waltermin/recurse-charm-hardware/rc_keychain.kicad_pcb

## KiCad design rc_keychain.kicad_pcb (2026-04-25)

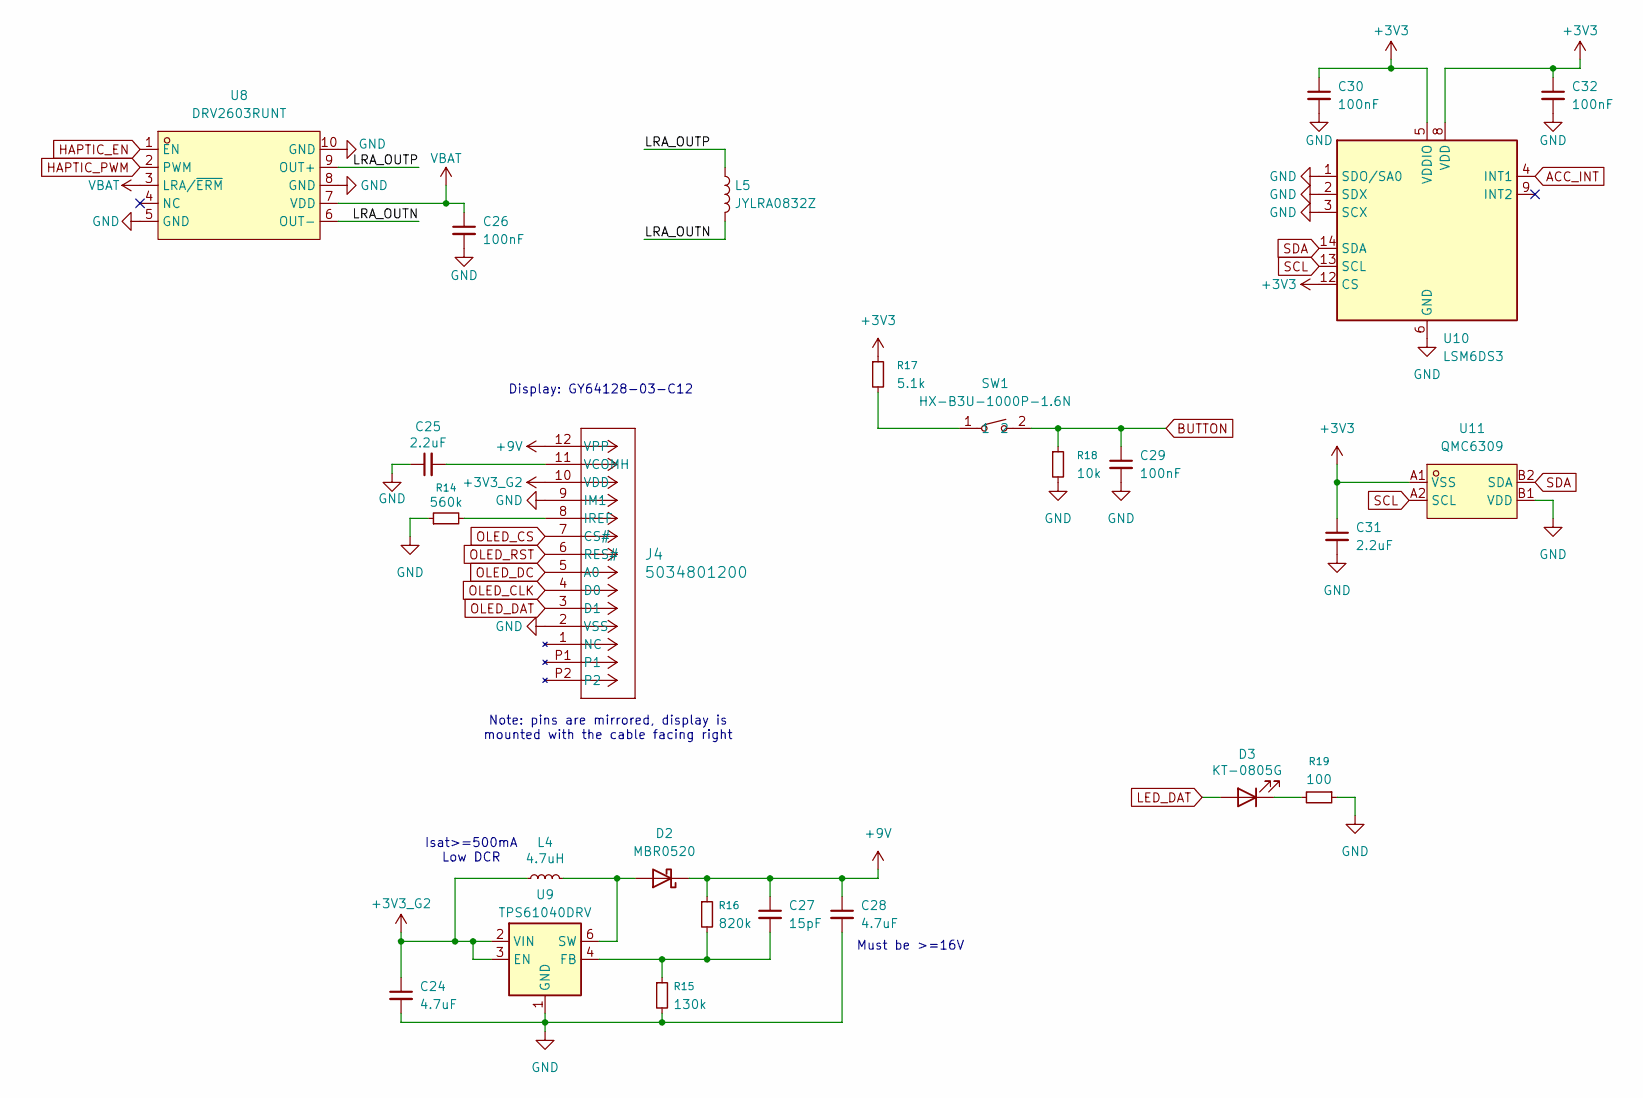
[picture p1: schematic interface.kicad_sch]

Parts:
C24: 4.7uF; C_0402_1005Metric; LCSC Part C23733
C25, C31: 2.2uF; C_0402_1005Metric; LCSC Part C12530
C26, C29, C30, C32: 100nF; C_0402_1005Metric; LCSC Part C1525
C27: 15pF; C_0402_1005Metric; LCSC Part C1548
C28: 4.7uF; C_0603_1608Metric; LCSC Part C19666
D2: MBR0520; D_SOD-323; LCSC Part C49238168
D3: KT-0805G; D_0805_2012Metric; LCSC Part C2297
J4: 5034801200; CON_5034801200_MOL; LCSC Part C587969
L4: 4.7uH; IND-SMD_L2.0-W1.6-B; LCSC Part C5832346
L5: JYLRA0832Z; Generic_Solder_Pads_2P
R14: 560k; R_0402_1005Metric; LCSC Part C132339
R15: 130k; R_0402_1005Metric; LCSC Part C93946
R16: 820k; R_0402_1005Metric; LCSC Part C67558
R17: 5.1k; R_0402_1005Metric; LCSC Part C25905
R18: 10k; R_0402_1005Metric; LCSC Part C25744
R19: 100; R_0402_1005Metric; LCSC Part C25076
SW1: HX-B3U-1000P-1.6N; SW-SMD_2P-L3.0-W2.5-LS4.0; MPN HX-B3U-1000P-1.6N; LCSC Part C49234121
U8: DRV2603RUNT; QFN-10_L2.0-W2.0-P0.50-TL; LCSC Part C2150691
U9: TPS61040DRV; WSON-6-1EP_2x2mm_P0.65mm_EP1x1.6mm; LCSC Part C2678534
U10: LSM6DS3; LGA-14_3x2.5mm_P0.5mm_LayoutBorder3x4y; LCSC Part C967633
U11: QMC6309; X1-WLB0808-4_L0.8-W0.8-P0.40-TL; MPN QMC6309; LCSC Part C5439871

Connections:
+3V3: C30.1, C31.1, C32.1, R17.1, U10.5 (VDDIO), U10.8 (VDD), U10.12 (CS), U11.A1 (VSS); also elsewhere on the board
+3V3_G2: C24.1, J4.10 (VDD), L4.1, U9.2 (VIN), U9.3 (EN); also elsewhere on the board
+9V: C27.1, C28.1, D2.1 (K), J4.12 (VPP), R16.1
/interface/LRA_OUTN: L5.2, U8.6 (OUT-)
/interface/LRA_OUTP: L5.1, U8.9 (OUT+)
ACC_INT: U10.4 (INT1); also elsewhere on the board
BUTTON: C29.1, R18.1, SW1.2; also elsewhere on the board
GND: C24.2, C25.1, C26.2, C28.2, C29.2, C30.2, C31.2, C32.2, J4.2 (VSS), J4.9 (IM1), R14.1, R15.2, R18.2, R19.1, U8.5 (GND), U8.8 (GND), U8.10 (GND), U9.1 (GND), U10.1 (SDO/SA0), U10.2 (SDX), U10.3 (SCX), U10.6 (GND), U10.7 (GND), U11.B1 (VDD); also elsewhere on the board
HAPTIC_EN: U8.1 (EN); also elsewhere on the board
HAPTIC_PWM: U8.2 (PWM); also elsewhere on the board
LED_DAT: D3.2 (A); also elsewhere on the board
unnamed: D2.2 (A), L4.2, U9.6 (SW)
unnamed: D3.1 (K), R19.2
unnamed: J4.8 (IREF), R14.2
unnamed: C25.2, J4.11 (VCOMH)
unnamed: R17.2, SW1.1
unnamed: C27.2, R15.1, R16.2, U9.4 (FB)
OLED_CLK: J4.4 (D0); also elsewhere on the board
OLED_CS: J4.7 (CS#); also elsewhere on the board
OLED_DAT: J4.3 (D1); also elsewhere on the board
OLED_DC: J4.5 (A0); also elsewhere on the board
OLED_RST: J4.6 (RES#); also elsewhere on the board
SCL: U10.13 (SCL), U11.A2 (SCL); also elsewhere on the board
SDA: U10.14 (SDA), U11.B2 (SDA); also elsewhere on the board
VBAT: C26.1, U8.3 (LRA/~ERM), U8.7 (VDD); also elsewhere on the board

Notes on the sheet:
Display: GY64128-03-C12
Isat>=500mA Low DCR
Note: pins are mirrored, display is mounted with the cable facing right
Must be >=16V

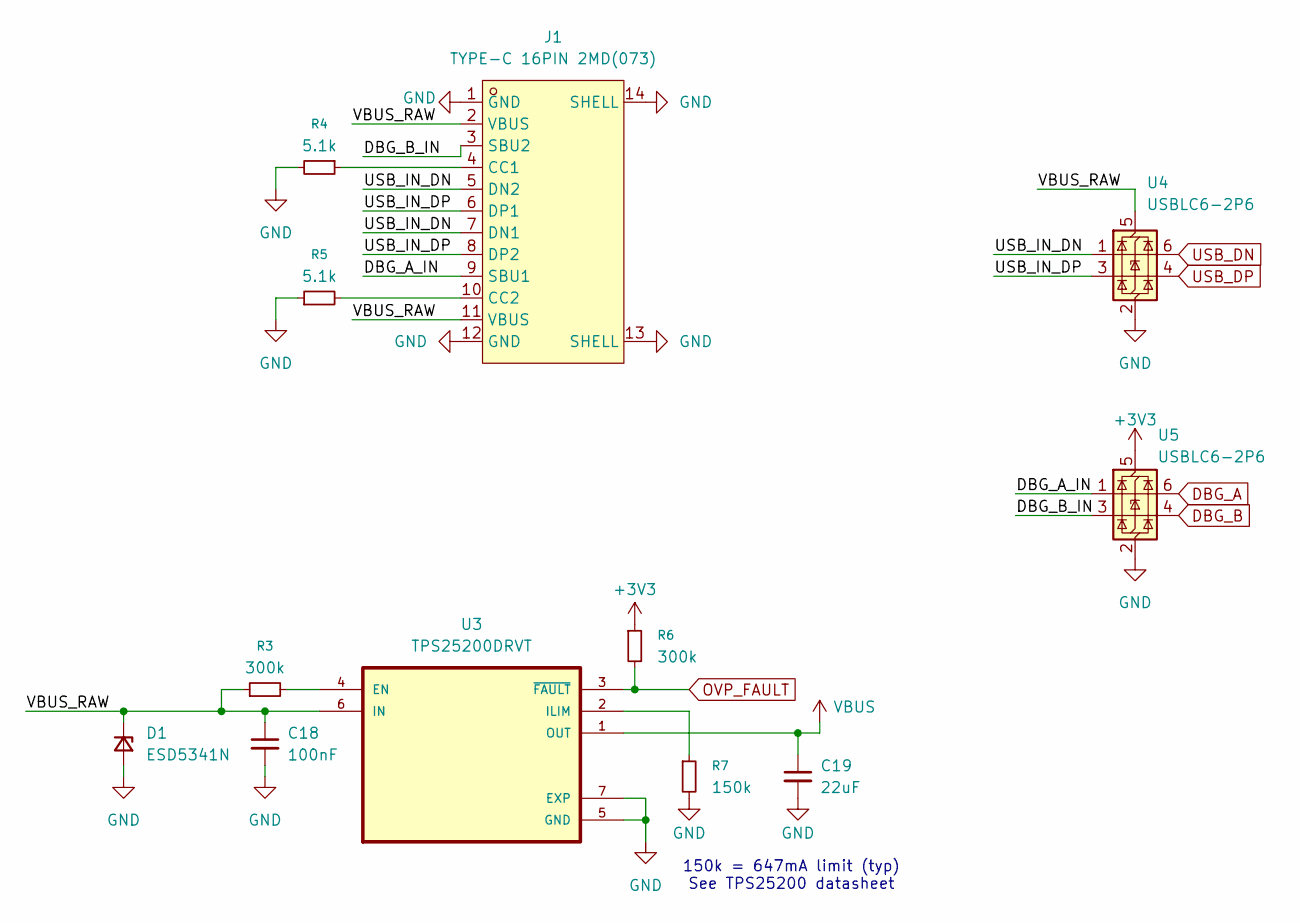
[picture p2: schematic usb.kicad_sch]

Parts:
C18: 100nF; C_0402_1005Metric; LCSC Part C1525
C19: 22uF; C_0402_1005Metric; LCSC Part C47339
D1: ESD5341N; D_SOD-882; LCSC Part C3021106
J1: TYPE-C 16PIN 2MD(073); USB-C-SMD_TYPE-C-6PIN-2MD-073; LCSC Part C2765186
R3, R6: 300k; R_0402_1005Metric; LCSC Part C25774
R4, R5: 5.1k; R_0402_1005Metric; LCSC Part C25905
R7: 150k; R_0402_1005Metric; LCSC Part C2909320
U3: TPS25200DRVT; SON65P200X200X80-7N; DigiKey_Part_Number 296-37760-1-ND
U4, U5: USBLC6-2P6; SOT-666; LCSC Part C2827693

Connections:
+3V3: R6.1, U5.5 (VBUS); also elsewhere on the board
/usb/DBG_A_IN: J1.9 (SBU1), U5.1 (I/O1)
/usb/DBG_B_IN: J1.3 (SBU2), U5.3 (I/O2)
/usb/USB_IN_DN: J1.5 (DN2), J1.7 (DN1), U4.1 (I/O1)
/usb/USB_IN_DP: J1.6 (DP1), J1.8 (DP2), U4.3 (I/O2)
/usb/VBUS_RAW: C18.1, D1.1 (K), J1.2 (VBUS), J1.11 (VBUS), R3.1, U3.6 (IN), U4.5 (VBUS)
DBG_A: U5.6 (I/O1); also elsewhere on the board
DBG_B: U5.4 (I/O2); also elsewhere on the board
GND: C18.2, C19.2, D1.2 (A), J1.1 (GND), J1.12 (GND), J1.13 (SHELL), J1.14 (SHELL), R4.2, R5.1, R7.2, U3.5 (GND), U3.7 (EXP), U4.2 (GND), U5.2 (GND); also elsewhere on the board
unnamed: J1.4 (CC1), R4.1
unnamed: J1.10 (CC2), R5.2
unnamed: R3.2, U3.4 (EN)
unnamed: R7.1, U3.2 (ILIM)
OVP_FAULT: R6.2, U3.3 (~FAULT)
USB_DN: U4.6 (I/O1); also elsewhere on the board
USB_DP: U4.4 (I/O2); also elsewhere on the board
VBUS: C19.1, U3.1 (OUT); also elsewhere on the board

Notes on the sheet:
150k = 647mA limit (typ) See TPS25200 datasheet

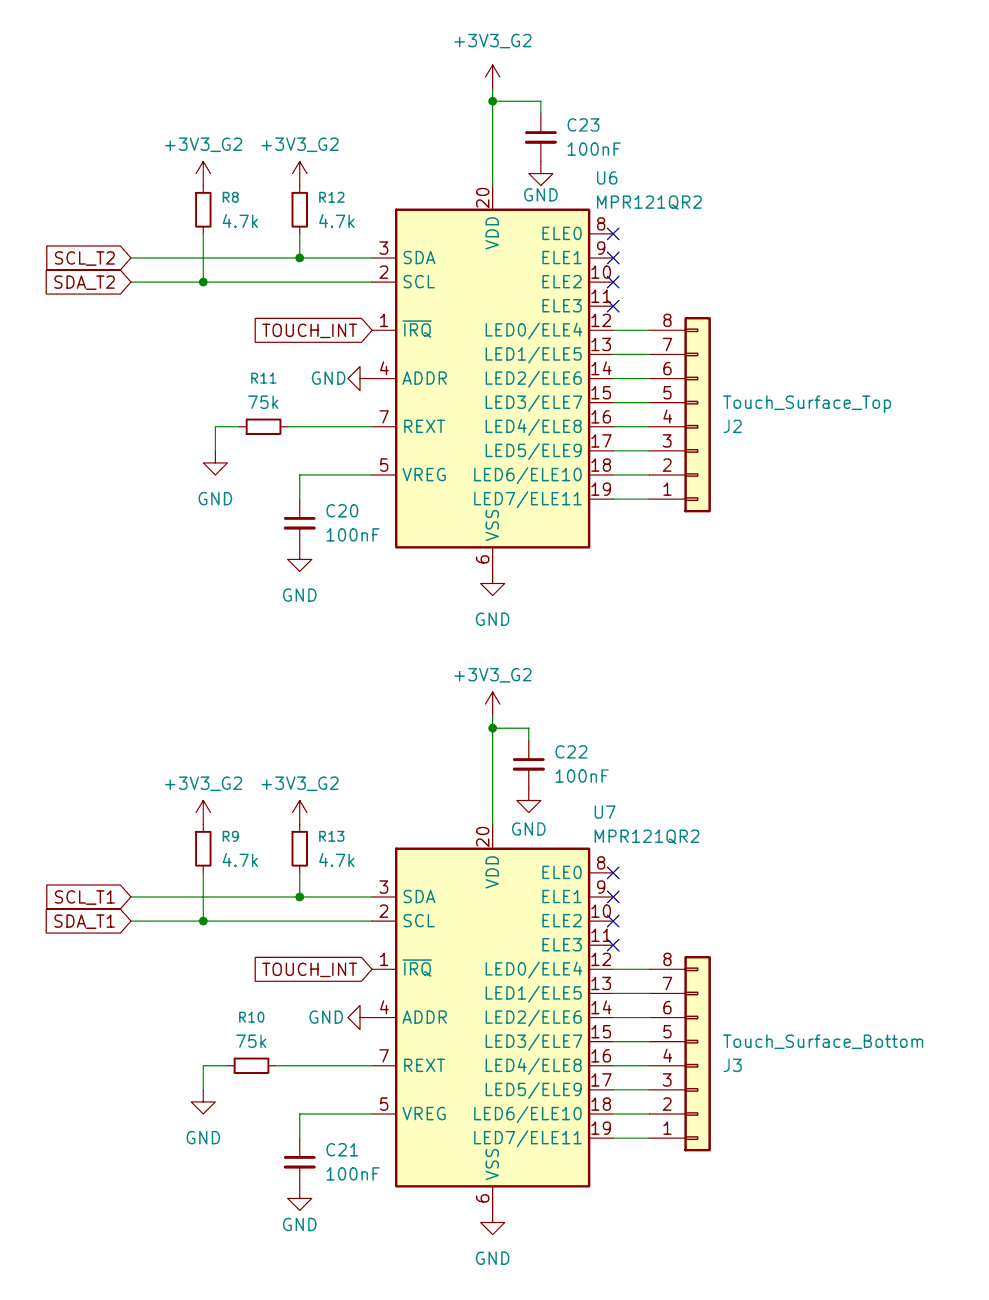
[picture p3: schematic touch.kicad_sch]

Parts:
C20, C21, C22, C23: 100nF; C_0402_1005Metric; LCSC Part C1525
J2: Touch_Surface_Top; Touch_Surface_8_Pad_Slim
J3: Touch_Surface_Bottom; Touch_Surface_8_Pad_Slim
R8, R9, R12, R13: 4.7k; R_0402_1005Metric; LCSC Part C25900
R10, R11: 75k; R_0402_1005Metric; LCSC Part C25798
U6, U7: MPR121QR2; UQFN-20_3x3mm_P0.4mm; LCSC Part C91322

Connections:
+3V3_G2: C22.1, C23.1, R8.1, R9.1, R12.1, R13.1, U6.20 (VDD), U7.20 (VDD); also elsewhere on the board
GND: C20.2, C21.2, C22.2, C23.2, R10.1, R11.1, U6.4 (ADDR), U6.6 (VSS), U7.4 (ADDR), U7.6 (VSS); also elsewhere on the board
unnamed: J2.1, U6.19 (LED7/ELE11)
unnamed: J2.2, U6.18 (LED6/ELE10)
unnamed: J2.3, U6.17 (LED5/ELE9)
unnamed: J2.4, U6.16 (LED4/ELE8)
unnamed: J2.5, U6.15 (LED3/ELE7)
unnamed: J2.6, U6.14 (LED2/ELE6)
unnamed: J2.7, U6.13 (LED1/ELE5)
unnamed: J2.8, U6.12 (LED0/ELE4)
unnamed: J3.1, U7.19 (LED7/ELE11)
unnamed: J3.2, U7.18 (LED6/ELE10)
unnamed: J3.3, U7.17 (LED5/ELE9)
unnamed: J3.4, U7.16 (LED4/ELE8)
unnamed: J3.5, U7.15 (LED3/ELE7)
unnamed: J3.6, U7.14 (LED2/ELE6)
unnamed: J3.7, U7.13 (LED1/ELE5)
unnamed: J3.8, U7.12 (LED0/ELE4)
unnamed: R11.2, U6.7 (REXT)
unnamed: C20.1, U6.5 (VREG)
unnamed: R10.2, U7.7 (REXT)
unnamed: C21.1, U7.5 (VREG)
SCL_T1: R13.2, U7.3 (SDA); also elsewhere on the board
SCL_T2: R12.2, U6.3 (SDA); also elsewhere on the board
SDA_T1: R9.2, U7.2 (SCL); also elsewhere on the board
SDA_T2: R8.2, U6.2 (SCL); also elsewhere on the board
TOUCH_INT: U6.1 (~IRQ), U7.1 (~IRQ); also elsewhere on the board

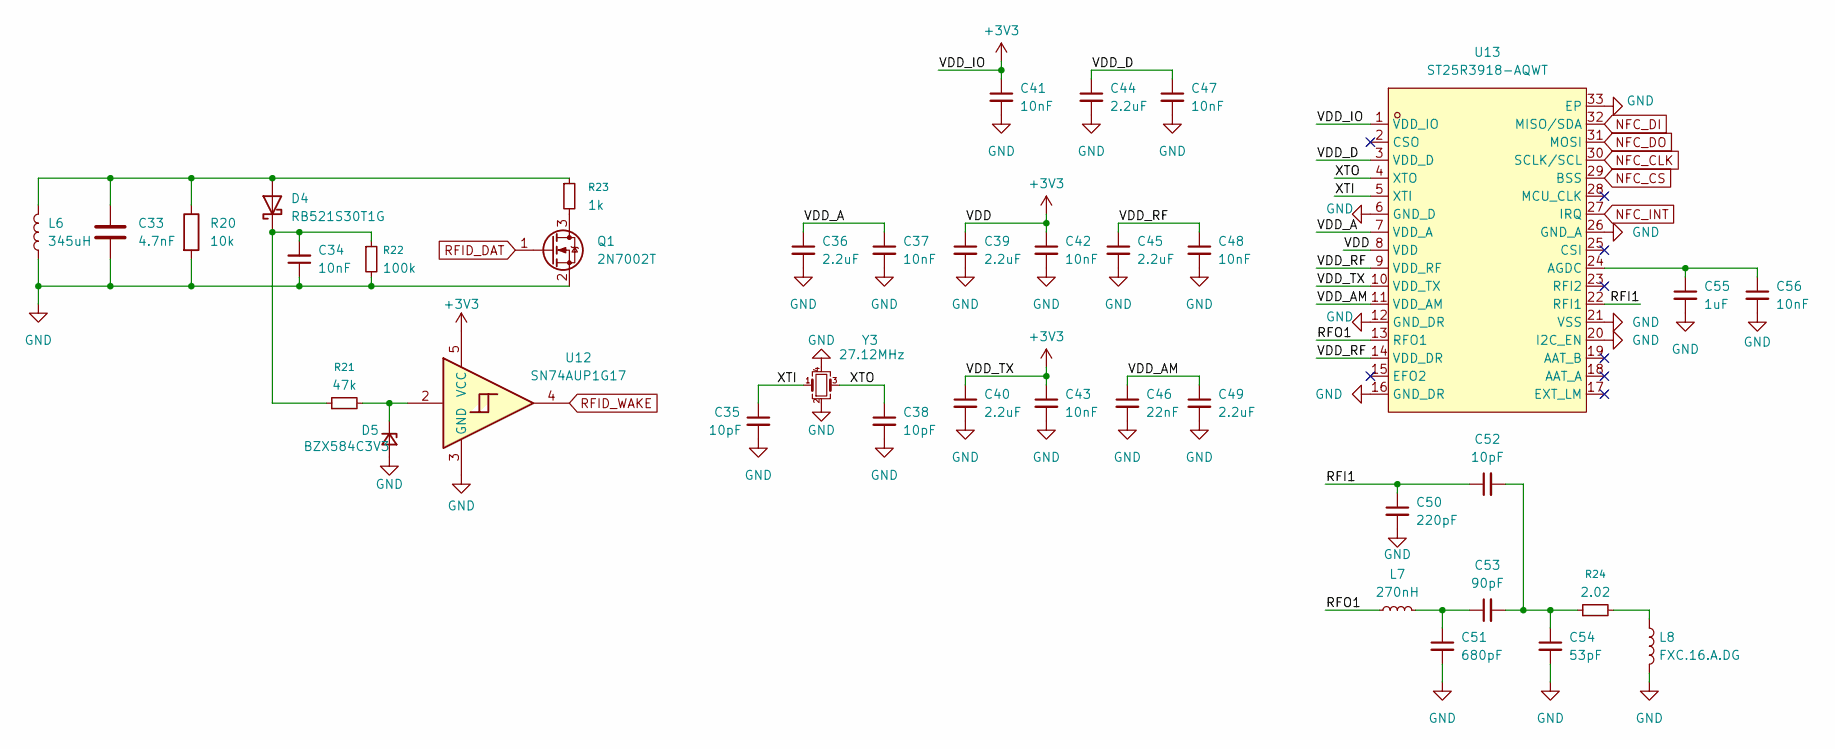
[picture p4: schematic rf.kicad_sch]

Parts:
C33: 4.7nF; C_0402_1005Metric; LCSC Part C1538
C34: 10nF; C_0402_1005Metric; LCSC Part C15195
C35, C38, C52: 10pF; C_0402_1005Metric; LCSC Part C32949
C36, C39, C40, C44, C45, C49: 2.2uF; C_0201_0603Metric; LCSC Part C335106
C37, C41, C42, C43, C47, C48, C56: 10nF; C_0201_0603Metric; LCSC Part C272853
C46: 22nF; C_0201_0603Metric; LCSC Part C668343
C50: 220pF; C_0402_1005Metric; LCSC Part C71693
C51: 680pF; C_0402_1005Metric; LCSC Part C307451
C53: 90pF; C_0402_1005Metric; LCSC Part C1864488
C54: 53pF; C_0402_1005Metric; LCSC Part C541437
C55: 1uF; C_0201_0603Metric; LCSC Part C53067
D4: RB521S30T1G; D_SOD-523; LCSC Part C145179
D5: BZX584C3V3; D_SOD-523; LCSC Part C19077462
L6: 345uH; Generic_Solder_Pads_2P
L7: 270nH; L_0603_1608Metric; LCSC Part C2041707
L8: FXC.16.A.DG; Generic_Solder_Pads_2P
Q1: 2N7002T; SOT-523; LCSC Part C2844731
R20: 10k; R_0402_1005Metric; LCSC Part C25744
R21: 47k; R_0402_1005Metric; LCSC Part C25792
R22: 100k; R_0402_1005Metric; LCSC Part C25741
R23: 1k; R_0402_1005Metric; LCSC Part C11702
R24: 2.02; R_0402_1005Metric; LCSC Part C2998051
U12: SN74AUP1G17; Diodes_SOT-553; LCSC Part C49374609
U13: ST25R3918-AQWT; QFN-32_L5.0-W5.0-P0.50-TL-EP3.5; LCSC Part C3304617
Y3: 27.12MHz; Crystal_SMD_2016-4Pin_2.0x1.6mm; LCSC Part C7301953

Connections:
+3V3: C39.1, C40.1, C41.1, C42.1, C43.1, U12.5 (VCC), U13.1 (VDD_IO), U13.8 (VDD), U13.10 (VDD_TX); also elsewhere on the board
/rf/RFI1: C50.1, C52.1, U13.22 (RFI1)
/rf/RFO1: L7.1, U13.13 (RFO1)
/rf/VDD_A: C36.1, C37.1, U13.7 (VDD_A)
/rf/VDD_AM: C46.1, C49.1, U13.11 (VDD_AM)
/rf/VDD_D: C44.1, C47.1, U13.3 (VDD_D)
/rf/VDD_RF: C45.1, C48.1, U13.9 (VDD_RF), U13.14 (VDD_DR)
/rf/XTI: C35.1, U13.5 (XTI), Y3.1
/rf/XTO: C38.1, U13.4 (XTO), Y3.3
GND: C33.2, C34.1, C35.2, C36.2, C37.2, C38.2, C39.2, C40.2, C41.2, C42.2, C43.2, C44.2, C45.2, C46.2, C47.2, C48.2, C49.2, C50.2, C51.2, C54.2, C55.2, C56.2, D5.2 (A), L6.1, L8.2, Q1.2 (S), R20.2, R22.2, U12.3 (GND), U13.6 (GND_D), U13.12 (GND_DR), U13.16 (GND_DR), U13.20 (I2C_EN), U13.21 (VSS), U13.26 (GND_A), U13.33 (EP), Y3.2, Y3.4; also elsewhere on the board
NFC_CLK: U13.30 (SCLK/SCL); also elsewhere on the board
NFC_CS: U13.29 (BSS); also elsewhere on the board
NFC_DI: U13.32 (MISO/SDA); also elsewhere on the board
NFC_DO: U13.31 (MOSI); also elsewhere on the board
NFC_INT: U13.27 (IRQ); also elsewhere on the board
unnamed: C51.1, C53.1, L7.2
unnamed: C52.2, C53.2, C54.1, R24.1
unnamed: C33.1, D4.2 (A), L6.2, R20.1, R23.1
unnamed: C34.2, D4.1 (K), R21.1, R22.1
unnamed: D5.1 (K), R21.2, U12.2
unnamed: L8.1, R24.2
unnamed: Q1.3 (D), R23.2
unnamed: C55.1, C56.1, U13.24 (AGDC)
RFID_DAT: Q1.1 (G); also elsewhere on the board
RFID_WAKE: U12.4; also elsewhere on the board

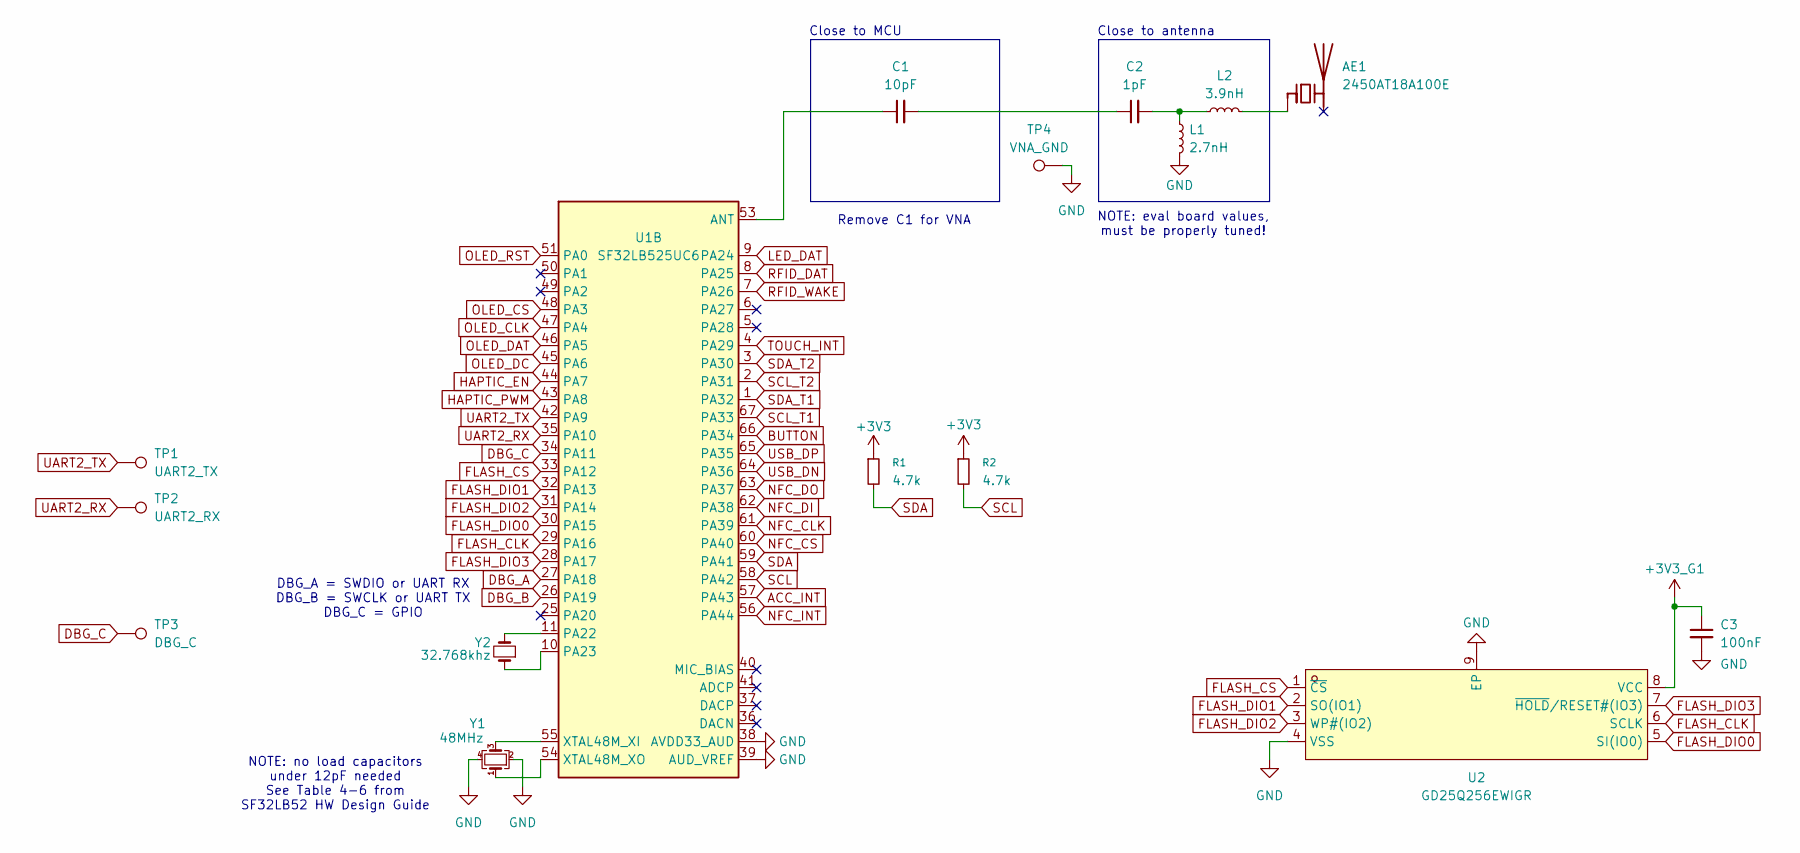
[picture p5: schematic mcu.kicad_sch]

Parts:
AE1: 2450AT18A100E; R_1206_3216Metric; LCSC Part C89334
C1: 10pF; C_0402_1005Metric; LCSC Part C32949
C2: 1pF; C_0603_1608Metric; LCSC Part C307493
C3: 100nF; C_0402_1005Metric; LCSC Part C1525
L1: 2.7nH; L_0603_1608Metric; LCSC Part C412027
L2: 3.9nH; L_0603_1608Metric; LCSC Part C13818
R1, R2: 4.7k; R_0402_1005Metric; LCSC Part C25900
TP1: UART2_TX; TestPoint_Pad_D1.0mm
TP2: UART2_RX; TestPoint_Pad_D1.0mm
TP3: DBG_C; TestPoint_Pad_D1.0mm
TP4: VNA_GND; TestPoint_Pad_D1.0mm
U1: SF32LB525UC6; ArtInChip_QFN-68-1EP_7x7mm_P0.35mm_EP5.49x5.49mm; LCSC Part C47355842
U2: GD25Q256EWIGR; WSON-8_L6.0-W5.0-P1.27-TL-EP; LCSC Part C6564321
Y1: 48MHz; Crystal_SMD_2016-4Pin_2.0x1.6mm; LCSC Part C49363531
Y2: 32.768khz; Crystal_SMD_2012-2Pin_2.0x1.2mm; LCSC Part C99009

Connections:
+3V3: R1.1, R2.1; also elsewhere on the board
+3V3_G1: C3.1, U2.8 (VCC); also elsewhere on the board
ACC_INT: U1.57 (PA43); also elsewhere on the board
BUTTON: U1.66 (PA34); also elsewhere on the board
DBG_A: U1.27 (PA18); also elsewhere on the board
DBG_B: U1.26 (PA19); also elsewhere on the board
DBG_C: TP3.1, U1.34 (PA11)
FLASH_CLK: U1.29 (PA16), U2.6 (SCLK)
FLASH_CS: U1.33 (PA12), U2.1 (~CS)
FLASH_DIO0: U1.30 (PA15), U2.5 (SI(IO0))
FLASH_DIO1: U1.32 (PA13), U2.2 (SO(IO1))
FLASH_DIO2: U1.31 (PA14), U2.3 (WP#(IO2))
FLASH_DIO3: U1.28 (PA17), U2.7 (~HOLD/RESET#(IO3))
GND: C3.2, L1.2, TP4.1, U1.38 (AVDD33_AUD), U1.39 (AUD_VREF), U2.4 (VSS), U2.9 (EP), Y1.2, Y1.4; also elsewhere on the board
HAPTIC_EN: U1.44 (PA7); also elsewhere on the board
HAPTIC_PWM: U1.43 (PA8); also elsewhere on the board
LED_DAT: U1.9 (PA24); also elsewhere on the board
NFC_CLK: U1.61 (PA39); also elsewhere on the board
NFC_CS: U1.60 (PA40); also elsewhere on the board
NFC_DI: U1.62 (PA38); also elsewhere on the board
NFC_DO: U1.63 (PA37); also elsewhere on the board
NFC_INT: U1.56 (PA44); also elsewhere on the board
unnamed: AE1.1 (FEED), L2.2
unnamed: C1.2, C2.1
unnamed: C2.2, L1.1, L2.1
unnamed: C1.1, U1.53 (ANT)
unnamed: U1.11 (PA22), Y2.2
unnamed: U1.10 (PA23), Y2.1
unnamed: U1.55 (XTAL48M_XI), Y1.3
unnamed: U1.54 (XTAL48M_XO), Y1.1
OLED_CLK: U1.47 (PA4); also elsewhere on the board
OLED_CS: U1.48 (PA3); also elsewhere on the board
OLED_DAT: U1.46 (PA5); also elsewhere on the board
OLED_DC: U1.45 (PA6); also elsewhere on the board
OLED_RST: U1.51 (PA0); also elsewhere on the board
RFID_DAT: U1.8 (PA25); also elsewhere on the board
RFID_WAKE: U1.7 (PA26); also elsewhere on the board
SCL: R2.2, U1.58 (PA42); also elsewhere on the board
SCL_T1: U1.67 (PA33); also elsewhere on the board
SCL_T2: U1.2 (PA31); also elsewhere on the board
SDA: R1.2, U1.59 (PA41); also elsewhere on the board
SDA_T1: U1.1 (PA32); also elsewhere on the board
SDA_T2: U1.3 (PA30); also elsewhere on the board
TOUCH_INT: U1.4 (PA29); also elsewhere on the board
UART2_RX: TP2.1, U1.35 (PA10)
UART2_TX: TP1.1, U1.42 (PA9)
USB_DN: U1.64 (PA36); also elsewhere on the board
USB_DP: U1.65 (PA35); also elsewhere on the board

Notes on the sheet:
NOTE: eval board values, must be properly tuned!
Remove C1 for VNA
Close to MCU
DBG_A = SWDIO or UART RX DBG_B = SWCLK or UART TX DBG_C = GPIO
NOTE: no load capacitors under 12pF needed See Table 4-6 from SF32LB52 HW Design Guide
Close to antenna

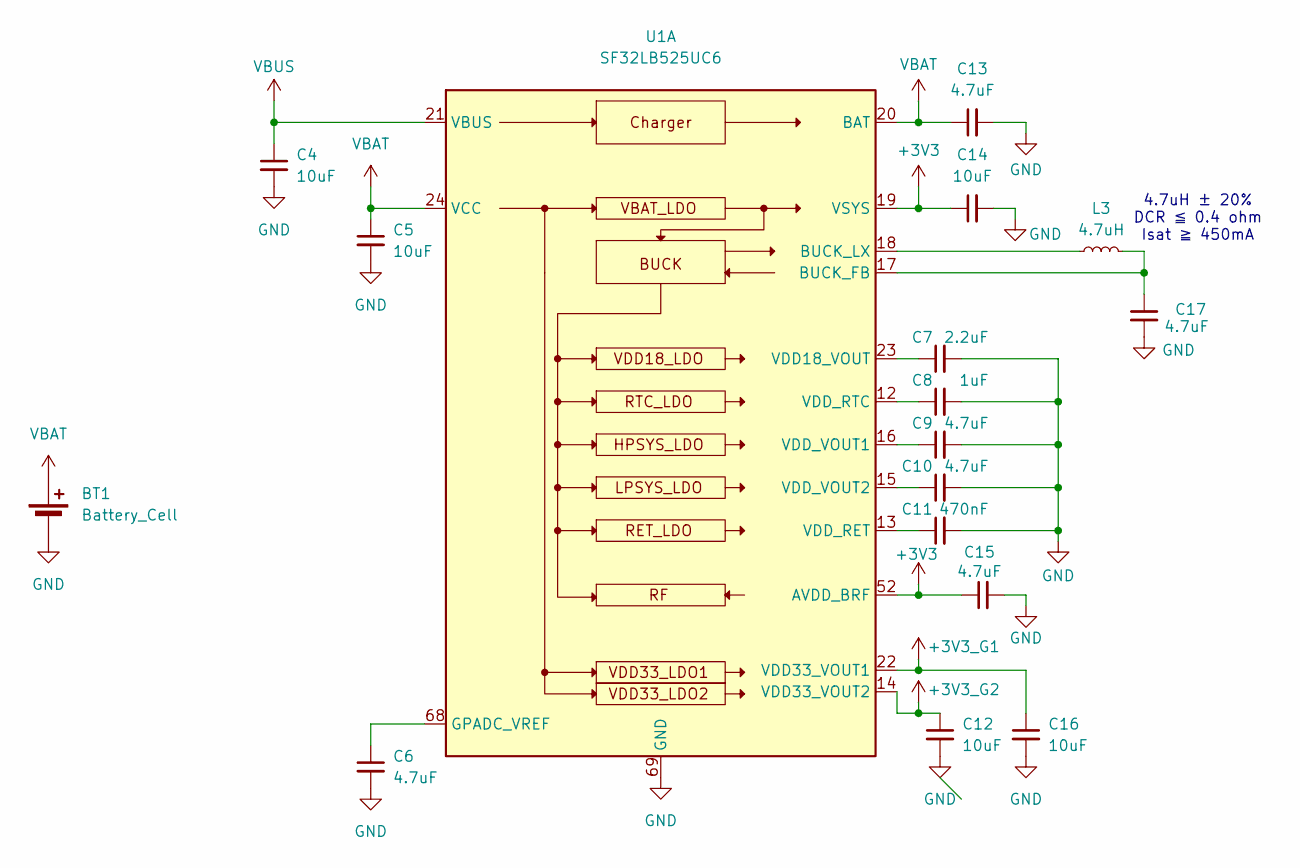
[picture p6: schematic power.kicad_sch]

Parts:
BT1: Battery_Cell; Generic_Solder_Pads_2P
C4, C5, C12, C14, C16: 10uF; C_0402_1005Metric; LCSC Part C15525
C6, C9, C10, C15: 4.7uF; C_0201_0603Metric; LCSC Part C335103
C7: 2.2uF; C_0201_0603Metric; LCSC Part C335106
C8: 1uF; C_0201_0603Metric; LCSC Part C53067
C11: 470nF; C_0201_0603Metric; LCSC Part C85926
C13, C17: 4.7uF; C_0402_1005Metric; LCSC Part C23733
L3: 4.7uH; L_0402_1005Metric; LCSC Part C86065
U1: SF32LB525UC6; ArtInChip_QFN-68-1EP_7x7mm_P0.35mm_EP5.49x5.49mm; LCSC Part C47355842

Connections:
+3V3: C14.1, C15.1, U1.19 (VSYS), U1.52 (AVDD_BRF); also elsewhere on the board
+3V3_G1: C16.1, U1.22 (VDD33_VOUT1); also elsewhere on the board
+3V3_G2: C12.1, U1.14 (VDD33_VOUT2); also elsewhere on the board
GND: BT1.2 (-), C4.2, C5.2, C6.2, C7.2, C8.2, C9.2, C10.2, C11.2, C12.2, C13.2, C14.2, C15.2, C16.2, C17.2, U1.69 (GND); also elsewhere on the board
unnamed: C17.1, L3.2, U1.17 (BUCK_FB)
unnamed: L3.1, U1.18 (BUCK_LX)
unnamed: C6.1, U1.68 (GPADC_VREF)
unnamed: C7.1, U1.23 (VDD18_VOUT)
unnamed: C11.1, U1.13 (VDD_RET)
unnamed: C8.1, U1.12 (VDD_RTC)
unnamed: C9.1, U1.16 (VDD_VOUT1)
unnamed: C10.1, U1.15 (VDD_VOUT2)
VBAT: BT1.1 (+), C5.1, C13.1, U1.20 (BAT), U1.24 (VCC); also elsewhere on the board
VBUS: C4.1, U1.21 (VBUS); also elsewhere on the board

Notes on the sheet:
4.7uH ± 20% DCR ≦ 0.4 ohm Isat ≧ 450mA

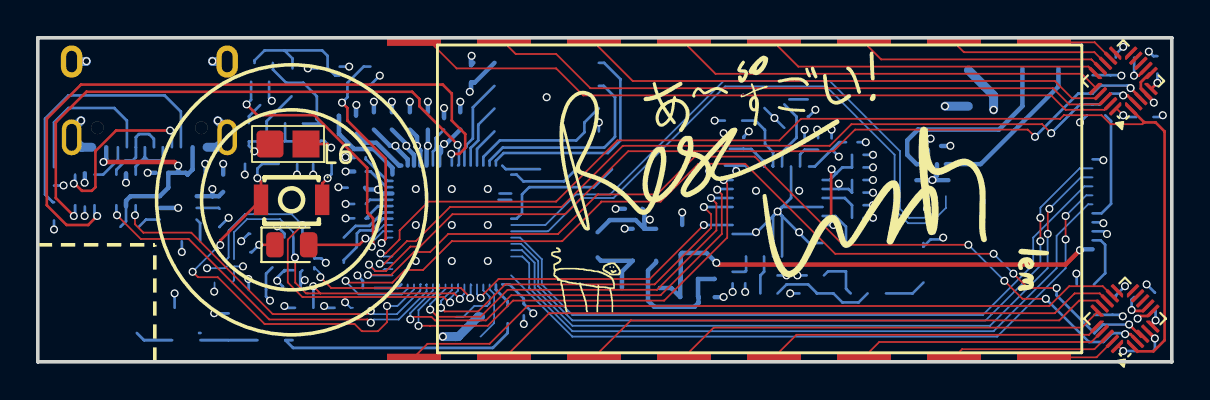
[picture p7: board rc_keychain.kicad_pcb from above]

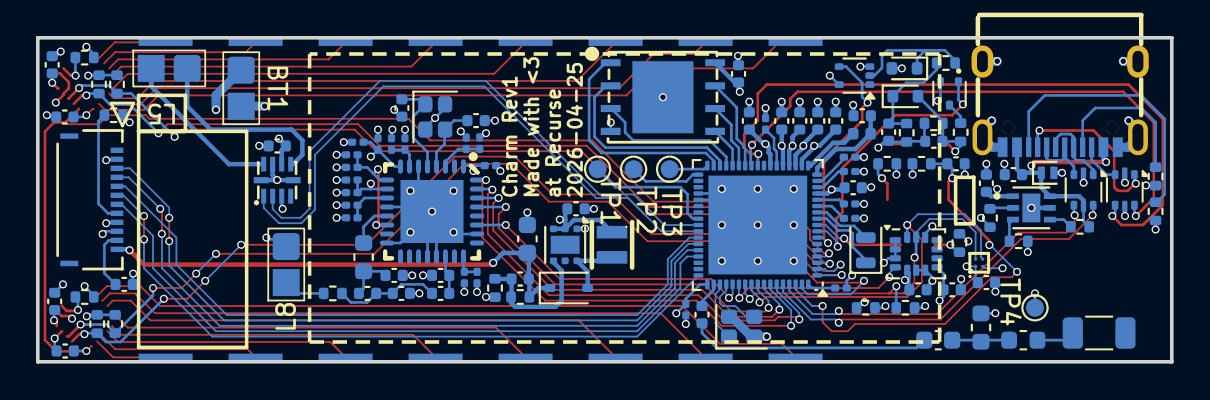
[picture p8: board rc_keychain.kicad_pcb from below]

Board: 4 copper layers, 63.0 x 18.0 mm, 121 parts (114 on the bottom side), 114 nets.
