waltermin/recurse-charm-hardware/(commit log)

2026-03-03 save progress before refactor
    [interface.kicad_sch, mcu.kicad_sch, power.kicad_sch, rc_keychain.kicad_pcb, touch.kicad_sch, usb.kicad_sch]
2026-03-05 progress dump
    [interface.kicad_sch, mcu.kicad_sch, rc_keychain.kicad_pcb, rc_keychain.kicad_sch, rf.kicad_sch, touch.kicad_sch]
2026-03-07 finish up everything but nfc
    [interface.kicad_sch, mcu.kicad_sch, power.kicad_sch, rc_keychain.kicad_pcb, rf.kicad_sch, touch.kicad_sch, usb.kicad_sch]
2026-03-11 push changes before removing fuel gauge
    [mcu.kicad_sch, rc_keychain.kicad_pcb, rf.kicad_sch, touch.kicad_sch, usb.kicad_sch]
2026-03-13 hopefully final schematic before splitting out
    [interface.kicad_sch, mcu.kicad_sch, power.kicad_sch, rc_keychain.kicad_pcb, rf.kicad_sch, touch.kicad_sch, usb.kicad_sch]
2026-03-14 final review, fixes, cleanup
    [interface.kicad_sch, mcu.kicad_sch, power.kicad_sch, usb.kicad_sch]
2026-03-14 prepare schematic for devboard
    [interface.kicad_sch, mcu.kicad_sch, power.kicad_sch, rf.kicad_sch, touch.kicad_sch, usb.kicad_sch]
2026-03-16 huge progress on bentoboard, schematic fixes
    [interface.kicad_sch, mcu.kicad_sch, power.kicad_sch, rc_keychain.kicad_pcb, rf.kicad_sch, touch.kicad_sch, usb.kicad_sch]
2026-03-17 rev1 done hopefully
    [mcu.kicad_sch, rc_keychain.kicad_pcb]
2026-03-17 fixups before manufacturing pt1
    [interface.kicad_sch, mcu.kicad_sch, rc_keychain.kicad_pcb, rf.kicad_sch]
2026-03-17 fixups before manufacturing pt2
    [mcu.kicad_sch, rc_keychain.kicad_pcb]
2026-03-18 final shipped rev1 bentoboard
    [usb.kicad_sch]
2026-04-12 oops fix: reversed diodes
    [interface.kicad_sch, rf.kicad_sch, usb.kicad_sch]
2026-04-12 oops fix: accelerometer
    [interface.kicad_sch]
2026-04-12 remove all jumpers
    [interface.kicad_sch, rf.kicad_sch, touch.kicad_sch, usb.kicad_sch]
2026-04-12 revise some decoupling caps to be 0201
    [interface.kicad_sch, power.kicad_sch, rc_keychain.kicad_pcb, rf.kicad_sch]
2026-04-12 layout progress
    [interface.kicad_sch, mcu.kicad_sch, power.kicad_sch, rc_keychain.kicad_pcb, rf.kicad_sch]
2026-04-19 progress 2
    [rc_keychain.kicad_pcb, rf.kicad_sch, usb.kicad_sch]
2026-04-19 progress 3
    [rc_keychain.kicad_pcb]
2026-04-19 progress 4
    [rc_keychain.kicad_pcb]
2026-04-19 progress 5
    [rc_keychain.kicad_pcb]
2026-04-21 progress before minor redesign
    [interface.kicad_sch, rc_keychain.kicad_pcb]
2026-04-21 progress before stepping
    [interface.kicad_sch, rc_keychain.kicad_pcb]
2026-04-21 progress before restarting bigtime
    [interface.kicad_sch, mcu.kicad_sch, rc_keychain.kicad_pcb]
2026-04-22 commit before not redesigning
    [rc_keychain.kicad_pcb]
2026-04-22 progress before finagling
    [interface.kicad_sch, rc_keychain.kicad_pcb]
2026-04-22 progress mid-finagling
    [interface.kicad_sch, rc_keychain.kicad_pcb, touch.kicad_sch]
2026-04-23 huge progress
    [interface.kicad_sch, mcu.kicad_sch, power.kicad_sch, rc_keychain.kicad_pcb, rf.kicad_sch, touch.kicad_sch]
2026-04-23 first draft of final board
    [interface.kicad_sch, mcu.kicad_sch, rc_keychain.kicad_pcb]
2026-04-25 final fixups before prod
    [interface.kicad_sch, mcu.kicad_sch, power.kicad_sch, rc_keychain.kicad_pcb, rf.kicad_sch, touch.kicad_sch, usb.kicad_sch]
